yggdrion/x1case/stl/frame_l.stl

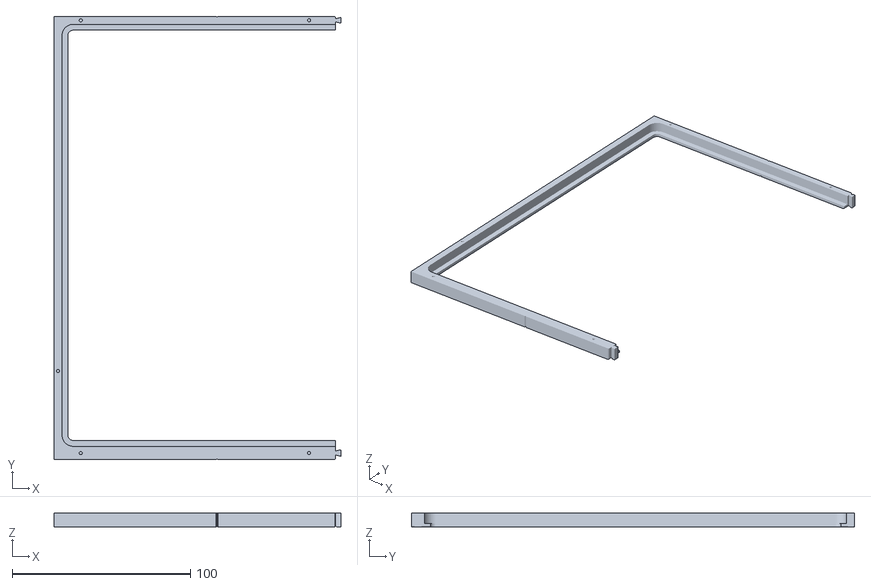
[picture p4: CAD file, 2026-11-14]
stl/frame_l.stl
160.9 x 248.6 x 8.00
