yggdrion/x1case/stl/tray_l.stl

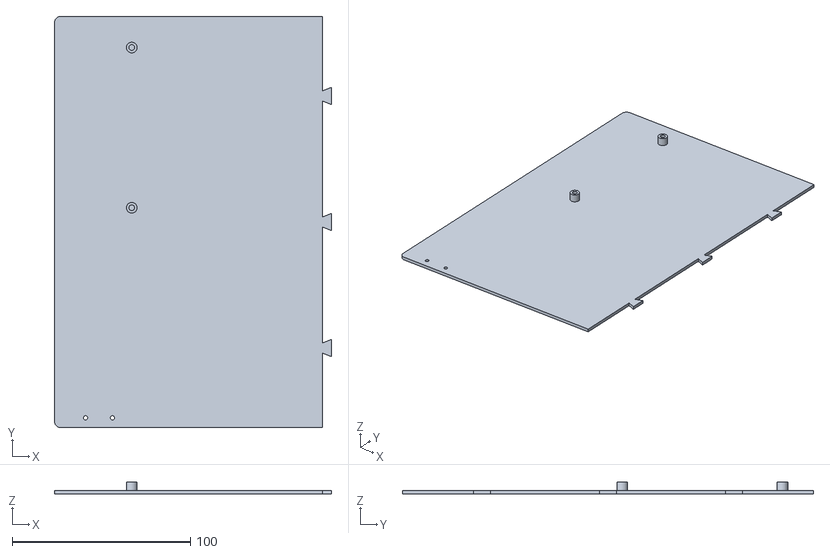
[picture p5: CAD file, 2026-11-14]
stl/tray_l.stl
155.6 x 231.0 x 6.99
