yggdrion/x1case/stl/frame_m.stl

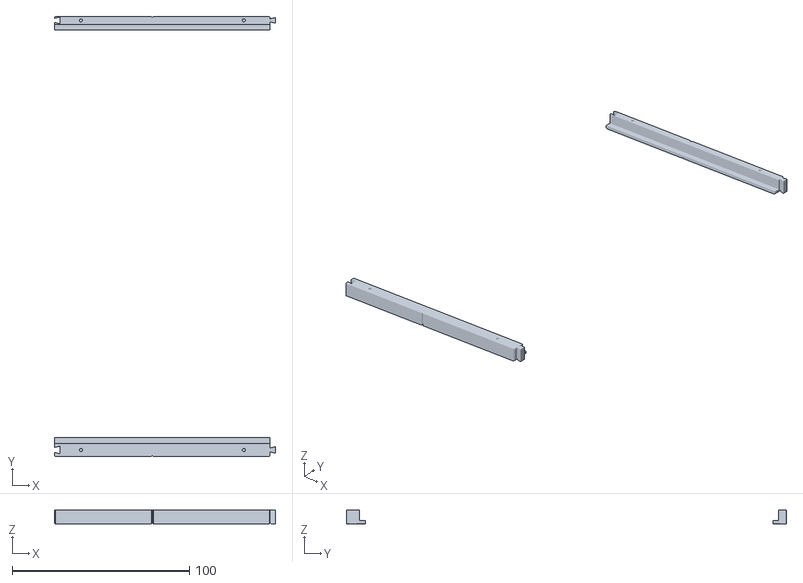
[picture p6: CAD file, 2026-11-14]
stl/frame_m.stl
124.8 x 248.6 x 8.00
