yggdrion/x1case/stl/tray_r.stl

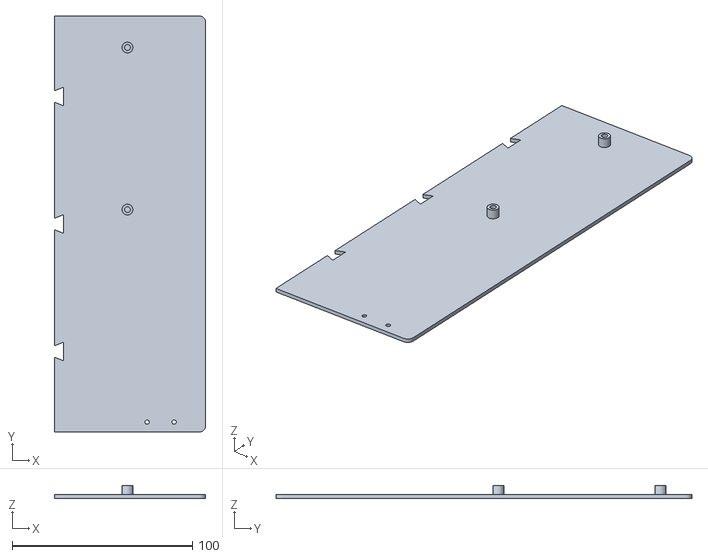
[picture p7: CAD file, 2026-11-14]
stl/tray_r.stl
84.0 x 231.0 x 6.99
