yggdrion/x1case/stl/shell_m.stl

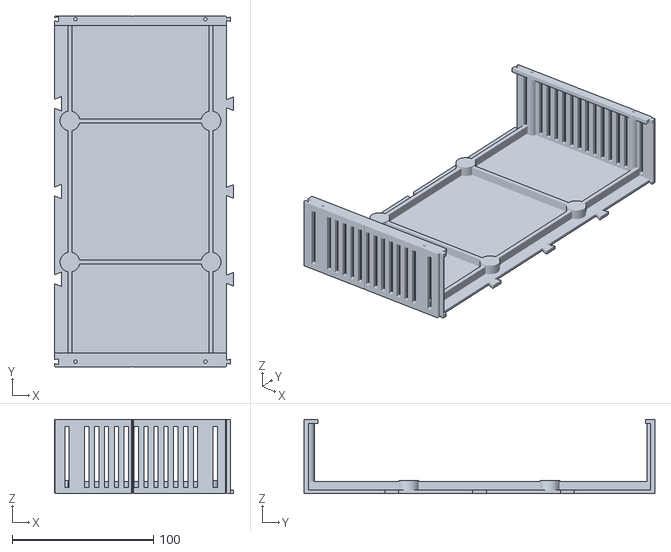
[picture p8: CAD file, 2026-11-14]
stl/shell_m.stl
126.8 x 248.6 x 52.7
