yggdrion/x1case/stl/frame_r.stl

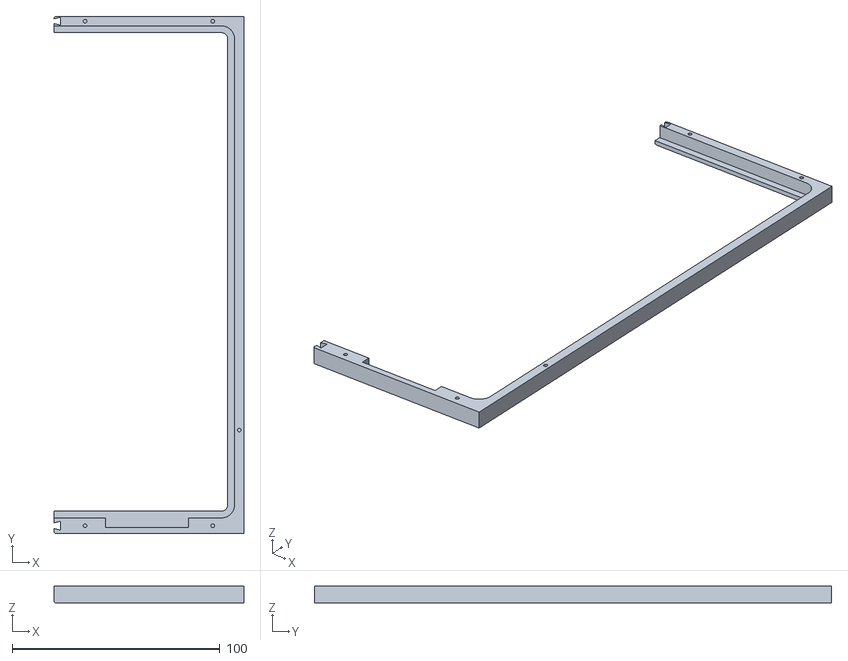
[picture p9: CAD file, 2026-11-14]
stl/frame_r.stl
91.3 x 248.6 x 8.00
