yggdrion/x1case/stl/tray_m.stl

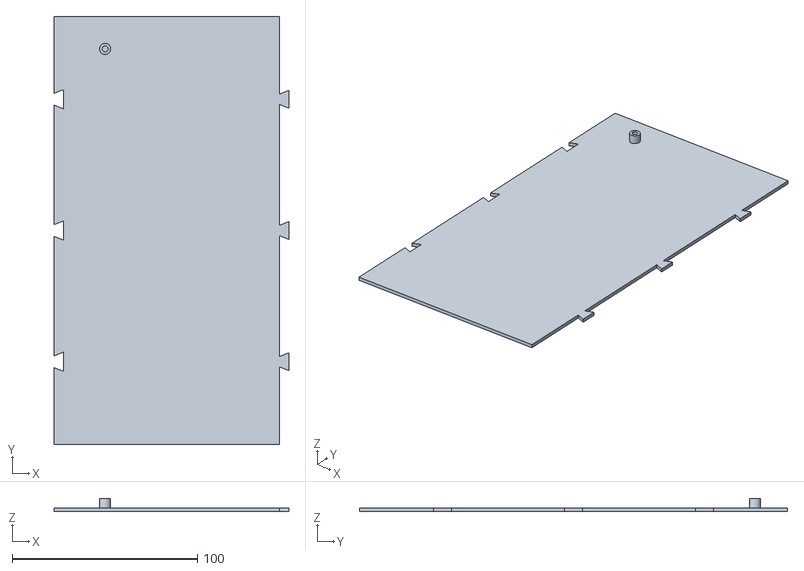
[picture p10: CAD file, 2026-11-14]
stl/tray_m.stl
126.8 x 231.0 x 6.99
