yggdrion/x1case/stl/shell_l.stl

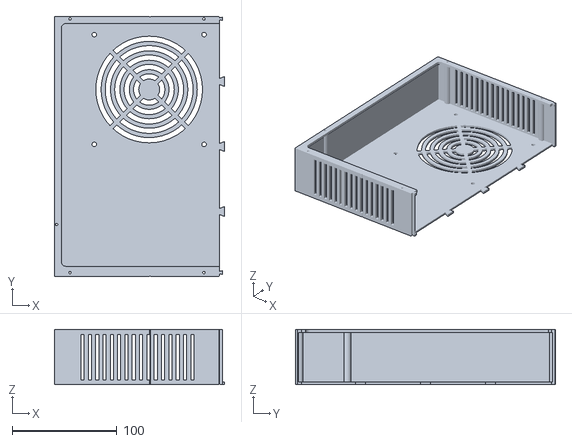
[picture p11: CAD file, 2026-11-14]
stl/shell_l.stl
162.9 x 248.6 x 52.7
