yggdrion/x1case/stl/shell_r.stl

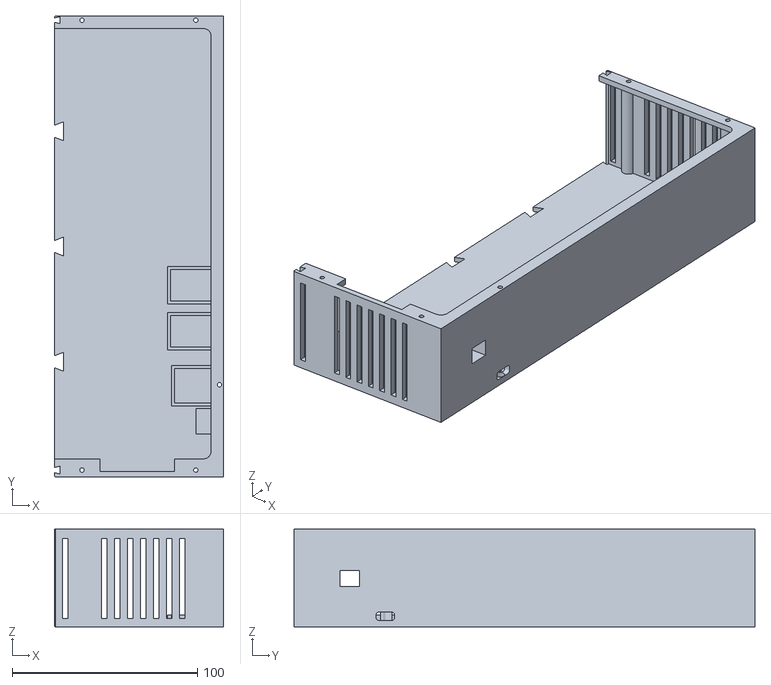
[picture p12: CAD file, 2026-11-14]
stl/shell_r.stl
91.3 x 248.6 x 52.7
