yggdrion/x1case/stl/test_seam.stl

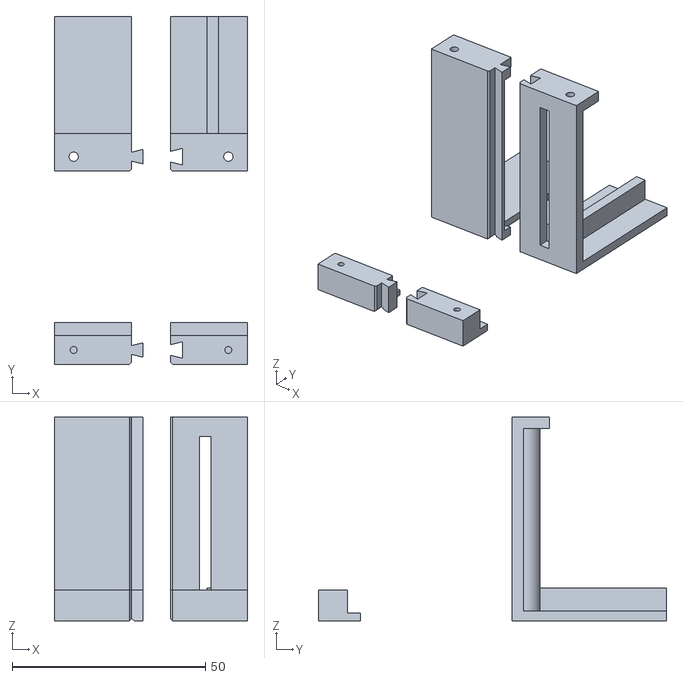
[picture p13: CAD file, 2026-11-14]
stl/test_seam.stl
50.0 x 90.0 x 52.7
