yggdrion/x1case/stl/test_corner.stl

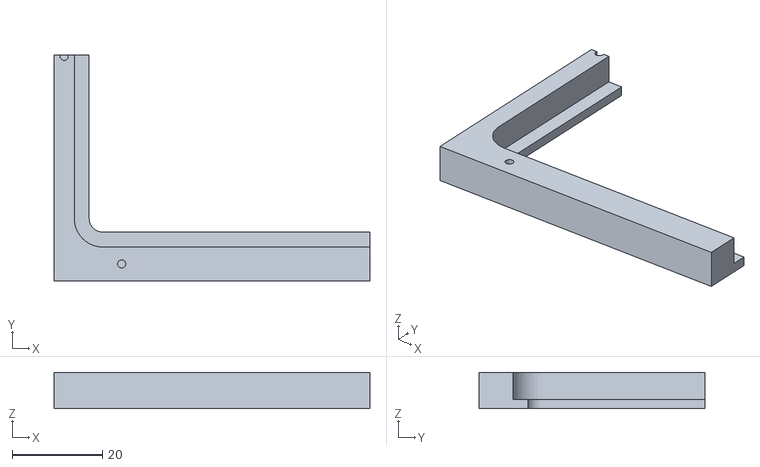
[picture p14: CAD file, 2026-11-14]
stl/test_corner.stl
70.0 x 50.0 x 8.00
