yggdrion/x1case/docs/measure.png

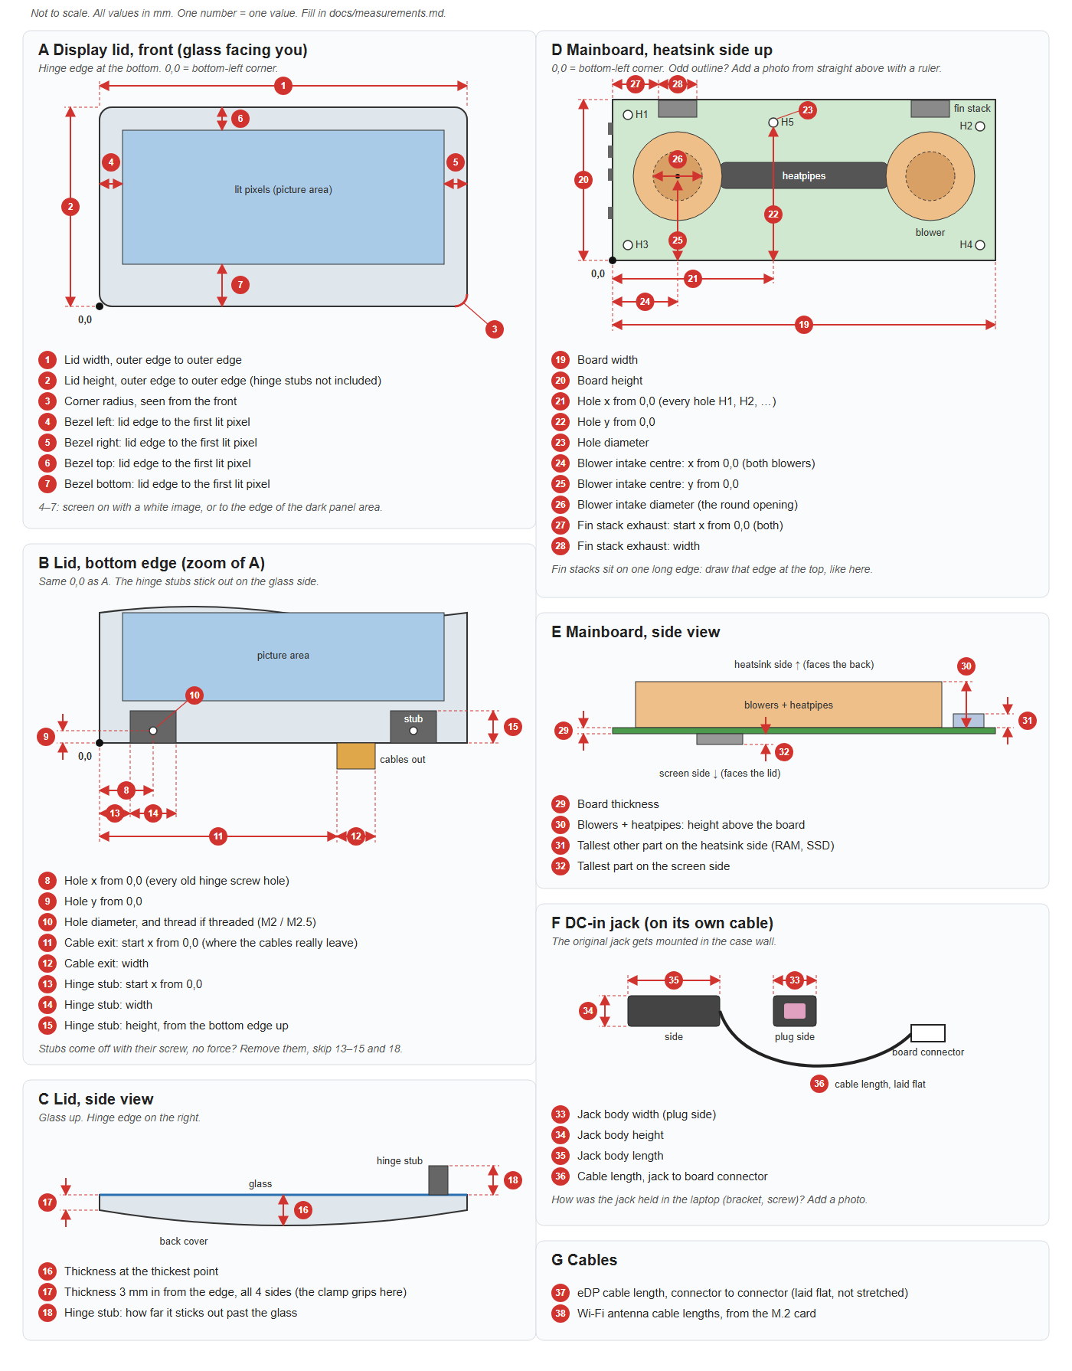
docs/measure.png
