yggdrion/x1case/images/test_corner.png

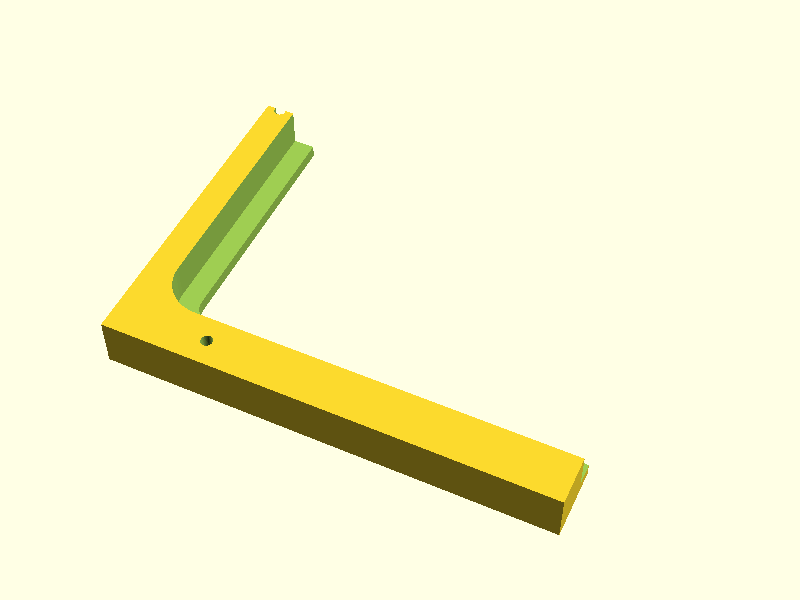
images/test_corner.png
