yggdrion/x1case/(commit log)

2026-11-07 feat(case): add parametric x1 extreme case skeleton
    Split frame, backer and shell into 3 bed-sized pieces with glued dovetails. Includes 120 mm fan grille, VESA 100 bosses, ESP32 bay and placeholder board/panel dimensions.
    [backer_l.stl, backer_m.stl, backer_r.stl, frame_l.stl, frame_m.stl, frame_r.stl, shell_l.stl, shell_m.stl]
2026-11-07 feat(case): switch to 25 mm fan and power-only port
    Drop board port cutouts; only DC-in is used through an internal cable. Add a DC plug keep-out check and shrink the placeholder board so it passes.
    [backer_l.stl, backer_r.stl, frame_l.stl, frame_m.stl, frame_r.stl, shell_l.stl, shell_m.stl, shell_r.stl]
2026-11-08 docs(measure): measure the display lid instead of the bare panel
    [backer_l.stl, backer_m.stl, backer_r.stl]
2026-11-08 feat(case)!: clamp the original display lid instead of a bare panel
    The lid stays intact and only the laptop base goes. The frame becomes a full edge clamp, the backer becomes a board tray anchored in the old hinge holes, and the bottom wall carries a cable channel. Shell screws switch to M2 self-tapping.
    [frame_l.stl, frame_m.stl, frame_r.stl, shell_l.stl, shell_m.stl, shell_r.stl, tray_l.stl, tray_m.stl]
2026-11-08 docs(panel): record machine type and panel from edid
    [x1case.scad]
2026-11-14 docs(measure): add edge thickness, hinge thread and hinge stub items
2026-11-14 feat(case): grip the lid at its edge thickness
    Frame pocket and shell rim use lid_t_edge; the tray and depth budget keep lid_t (thickest point). Defaults are equal, so geometry is unchanged.
    [x1case.scad]
2026-11-14 feat(test): add test_corner and test_seam fit coupons
    [test_corner.stl, test_seam.stl]
2026-11-14 feat(case)!: put the fan on a blower and mount the stock DC-in jack
    The stock cooler covers most of the board, so the 120 mm fan now sits on top of one blower and pushes into its intake; the depth budget stacks fan on heatsink (D 51.7 -> 60.7 mm). The DC-in jack is on its own cable, so the shell gets a sleeve for it instead of a round 5.5/2.1 jack, and the board-side plug check is gone. Seams move to [158, 280] to clear the fan and VESA pad. Replaces heatsink_pos/heatsink_size/fan_pos_x/dc_in_*/dc_plug_len/dc_jack_d with blowers, fin_exhausts, fan_blower and dc_jack.
    [frame_l.stl, frame_m.stl, frame_r.stl, shell_l.stl, shell_m.stl, shell_r.stl, test_seam.stl, tray_l.stl]
